ikajdan/PUTM_EV_REARBOX_2023/documentation/rearbox_layout.jpg

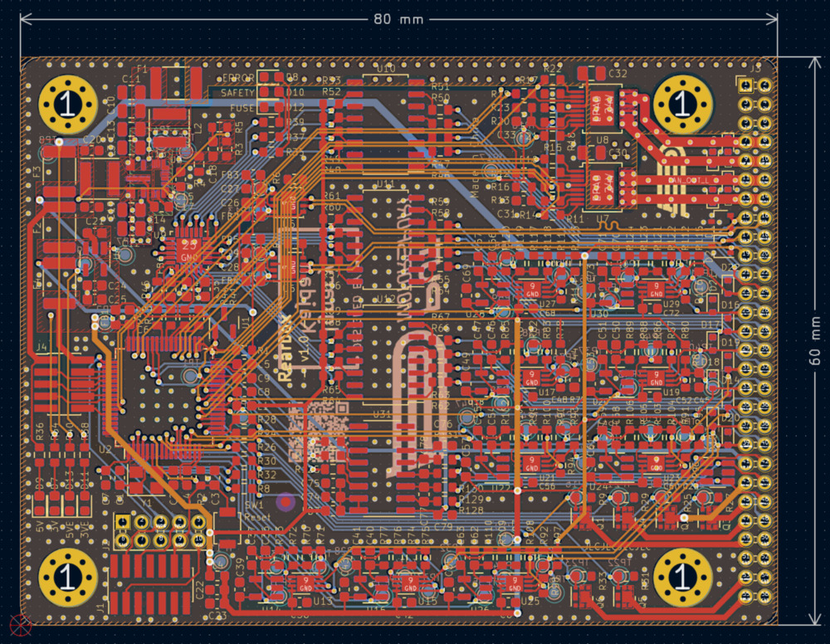
documentation/rearbox_layout.jpg
