ikajdan/PUTM_EV_REARBOX_2023/hardware/connector/models/DTS20W17-35SN.step

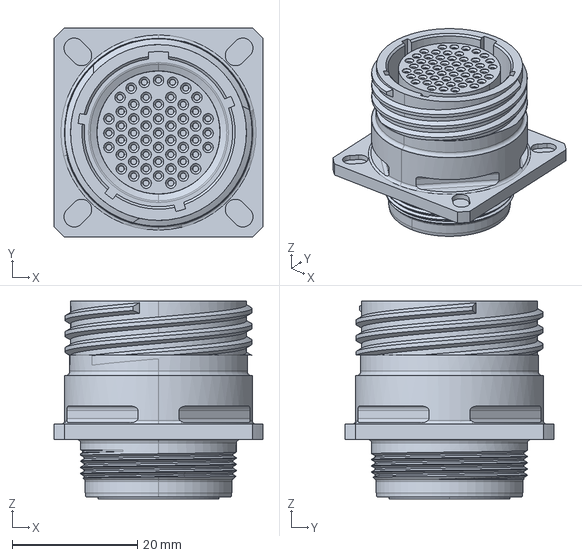
[picture p4: CAD file, 2024-04-28]
hardware/connector/models/DTS20W17-35SN.step
33.4 x 33.4 x 31.6 mm
