ikajdan/PUTM_EV_REARBOX_2023/hardware/rearbox/models/BUK6D210.step

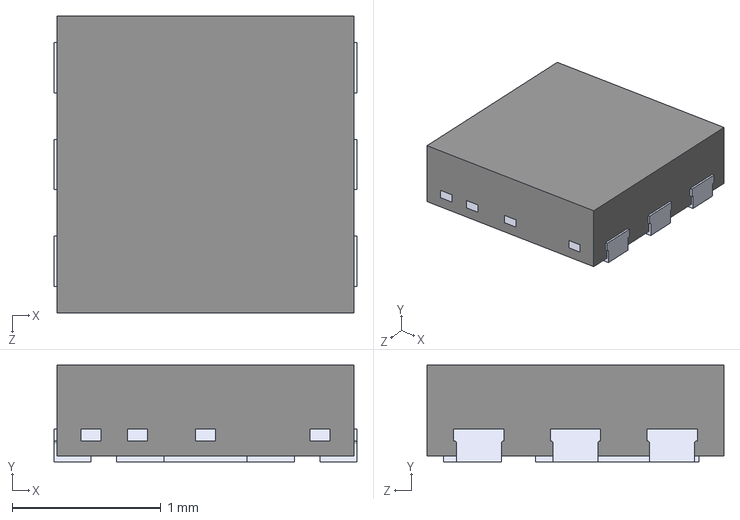
[picture p5: CAD file, 2023-11-16]
hardware/rearbox/models/BUK6D210.step
2.04 x 0.65 x 2.00 mm
