ikajdan/PUTM_EV_REARBOX_2023/hardware/rearbox/models/TCA6416ARTWR.step

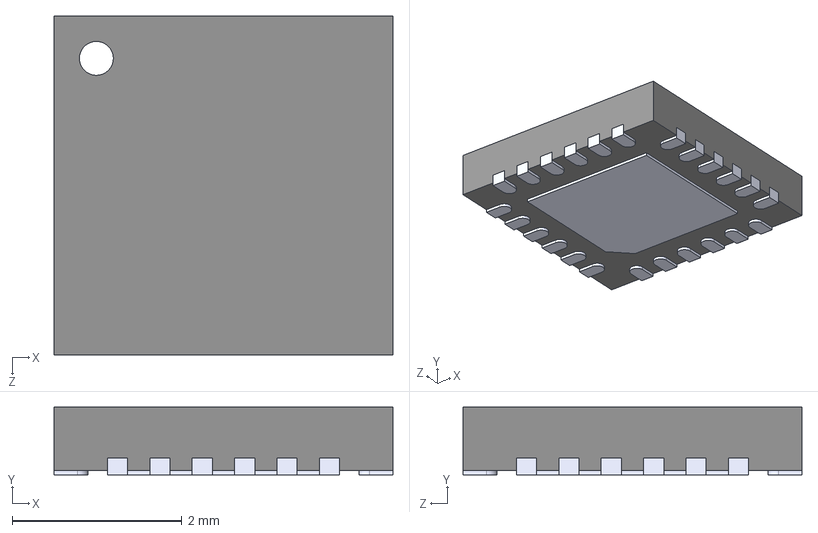
[picture p6: CAD file, 2023-10-03]
hardware/rearbox/models/TCA6416ARTWR.step
4.00 x 0.8 x 4.00 mm
