ikajdan/PUTM_EV_REARBOX_2023/hardware/rearbox/models/LM62440.step

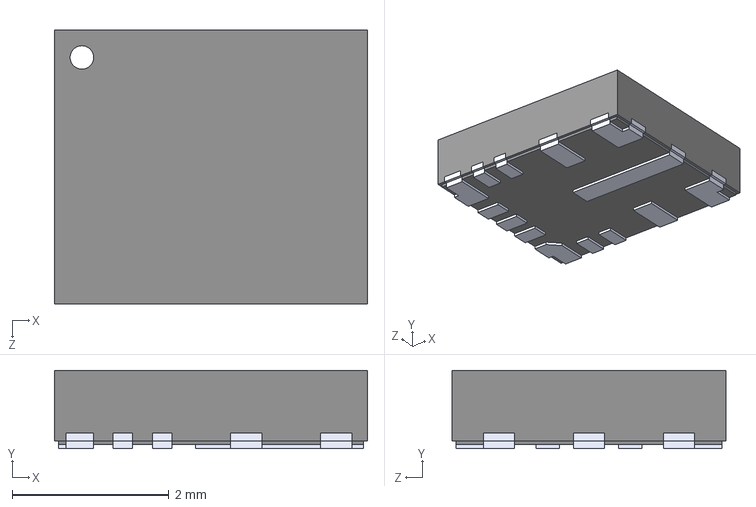
[picture p7: CAD file, 2023-11-16]
hardware/rearbox/models/LM62440.step
4.00 x 1.00 x 3.50 mm
