ikajdan/PUTM_EV_REARBOX_2023/hardware/connector/connector.kicad_pcb

## KiCad design hardware/connector/connector.kicad_pcb (2024-05-31)

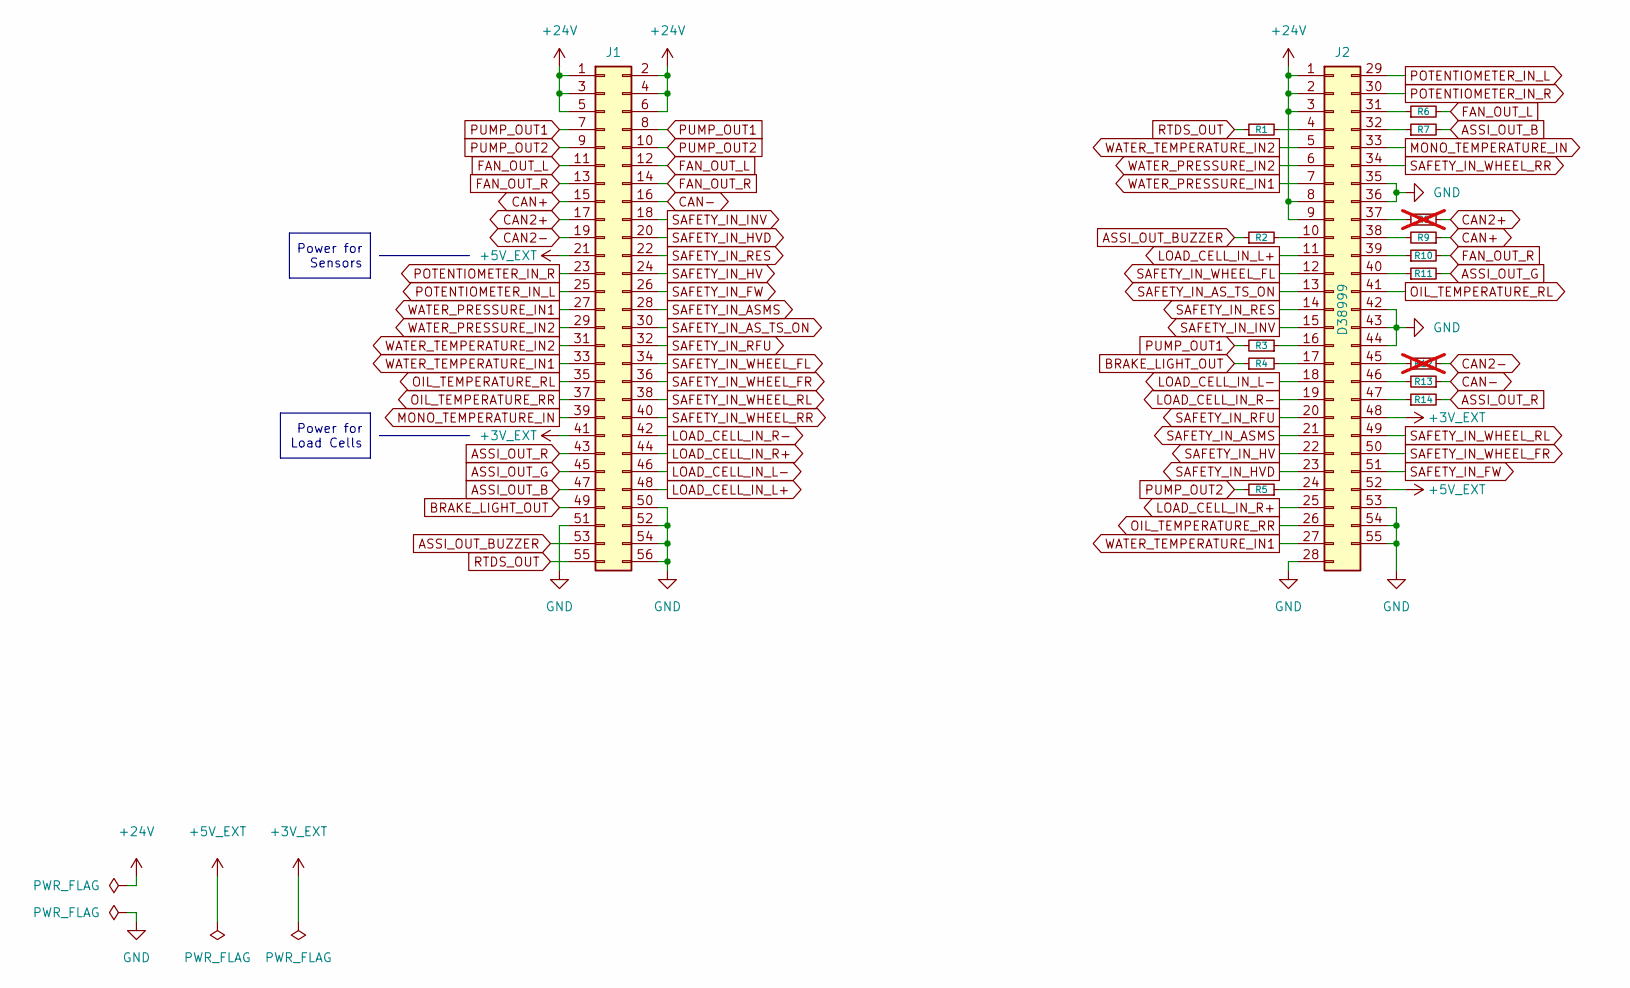
[picture p8: schematic connector.kicad_sch, Connector Board]

Parts:
J1: Conn_02x28_Top_Bottom; PinHeader_2x28_P2.00mm_Horizontal
J2: D38999; DTS20W17-35SN
R1, R2, R3, R4, R5, R6, R7, R9, R10, R11, R13, R14: 0R; R_0603_1608Metric
R8, R12: 0R; R_0603_1608Metric; not fitted

Connections:
+3V_EXT: J1.41, J2.48
+5V_EXT: J1.21, J2.52
+24V: J1.1, J1.2, J1.3, J1.4, J1.5, J1.6, J2.1, J2.2, J2.3, J2.8, J2.9
ASSI_OUT_B: J1.47, R7.2
ASSI_OUT_BUZZER: J1.53, R2.1
ASSI_OUT_G: J1.45, R11.2
ASSI_OUT_R: J1.43, R14.2
BRAKE_LIGHT_OUT: J1.49, R4.1
CAN2+: J1.17, R8.1
CAN2-: J1.19, R12.1
CAN+: J1.15, R9.1
CAN-: J1.16, R13.1
FAN_OUT_L: J1.11, J1.12, R6.2
FAN_OUT_R: J1.13, J1.14, R10.2
GND: J1.50, J1.51, J1.52, J1.54, J1.56, J2.28, J2.35, J2.36, J2.42, J2.43, J2.44, J2.53, J2.54, J2.55
LOAD_CELL_IN_L+: J1.48, J2.11
LOAD_CELL_IN_L-: J1.46, J2.18
LOAD_CELL_IN_R+: J1.44, J2.25
LOAD_CELL_IN_R-: J1.42, J2.19
MONO_TEMPERATURE_IN: J1.39, J2.33
unnamed: J2.4, R1.2
unnamed: J2.10, R2.2
unnamed: J2.16, R3.1
unnamed: J2.17, R4.2
unnamed: J2.24, R5.1
unnamed: J2.31, R6.1
unnamed: J2.32, R7.1
unnamed: J2.37, R8.2
unnamed: J2.38, R9.2
unnamed: J2.39, R10.1
unnamed: J2.40, R11.1
unnamed: J2.45, R12.2
unnamed: J2.46, R13.2
unnamed: J2.47, R14.1
OIL_TEMPERATURE_RL: J1.35, J2.41
OIL_TEMPERATURE_RR: J1.37, J2.26
POTENTIOMETER_IN_L: J1.25, J2.29
POTENTIOMETER_IN_R: J1.23, J2.30
PUMP_OUT1: J1.7, J1.8, R3.2
PUMP_OUT2: J1.9, J1.10, R5.2
RTDS_OUT: J1.55, R1.1
SAFETY_IN_ASMS: J1.28, J2.21
SAFETY_IN_AS_TS_ON: J1.30, J2.13
SAFETY_IN_FW: J1.26, J2.51
SAFETY_IN_HV: J1.24, J2.22
SAFETY_IN_HVD: J1.20, J2.23
SAFETY_IN_INV: J1.18, J2.15
SAFETY_IN_RES: J1.22, J2.14
SAFETY_IN_RFU: J1.32, J2.20
SAFETY_IN_WHEEL_FL: J1.34, J2.12
SAFETY_IN_WHEEL_FR: J1.36, J2.50
SAFETY_IN_WHEEL_RL: J1.38, J2.49
SAFETY_IN_WHEEL_RR: J1.40, J2.34
WATER_PRESSURE_IN1: J1.27, J2.7
WATER_PRESSURE_IN2: J1.29, J2.6
WATER_TEMPERATURE_IN1: J1.33, J2.27
WATER_TEMPERATURE_IN2: J1.31, J2.5

Notes on the sheet:
Power for Sensors
Power for Load Cells

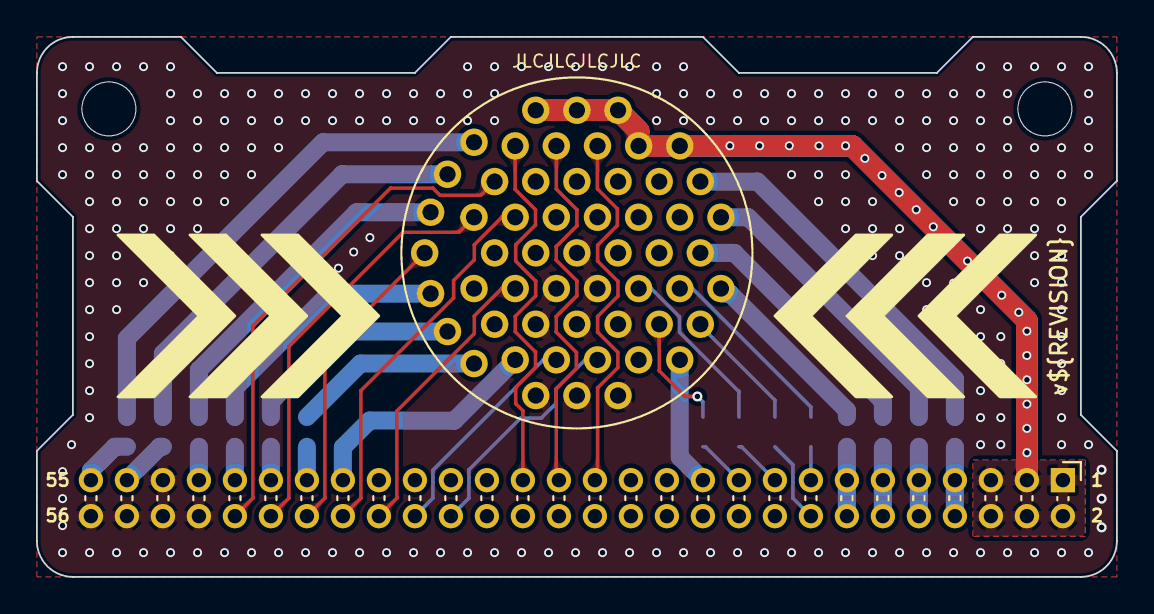
[picture p9: board connector.kicad_pcb from above]

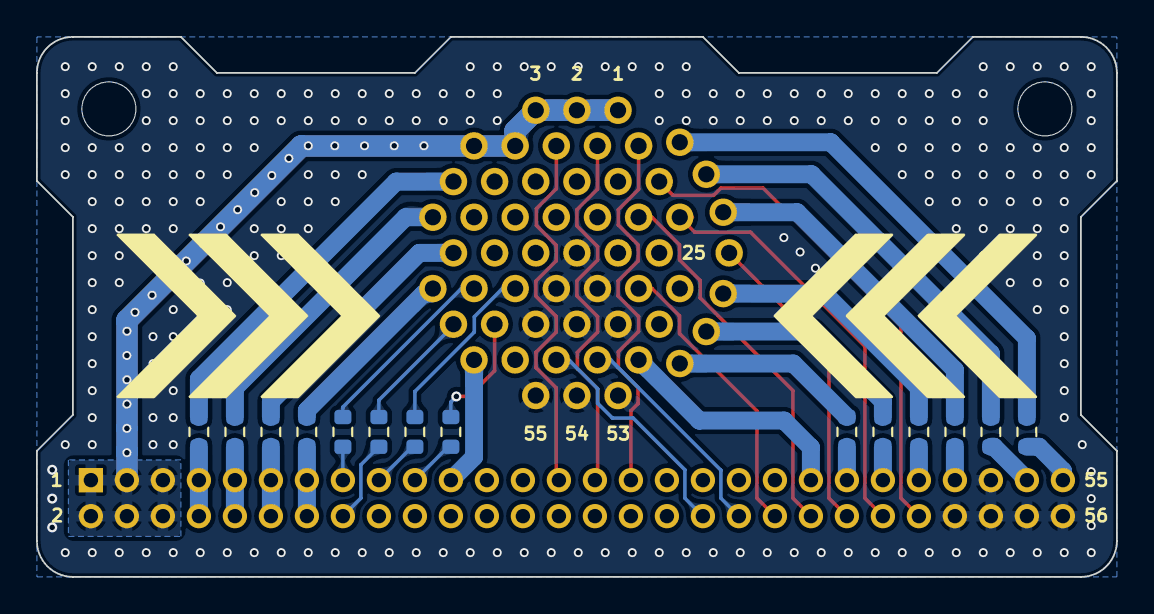
[picture p10: board connector.kicad_pcb from below]

Board: 4 copper layers, 60.0 x 30.0 mm, 16 parts (14 on the bottom side), 57 nets.
