ikajdan/PUTM_EV_REARBOX_2023/hardware/rearbox/rearbox.kicad_pcb

## KiCad design hardware/rearbox/rearbox.kicad_pcb (2023-11-07)

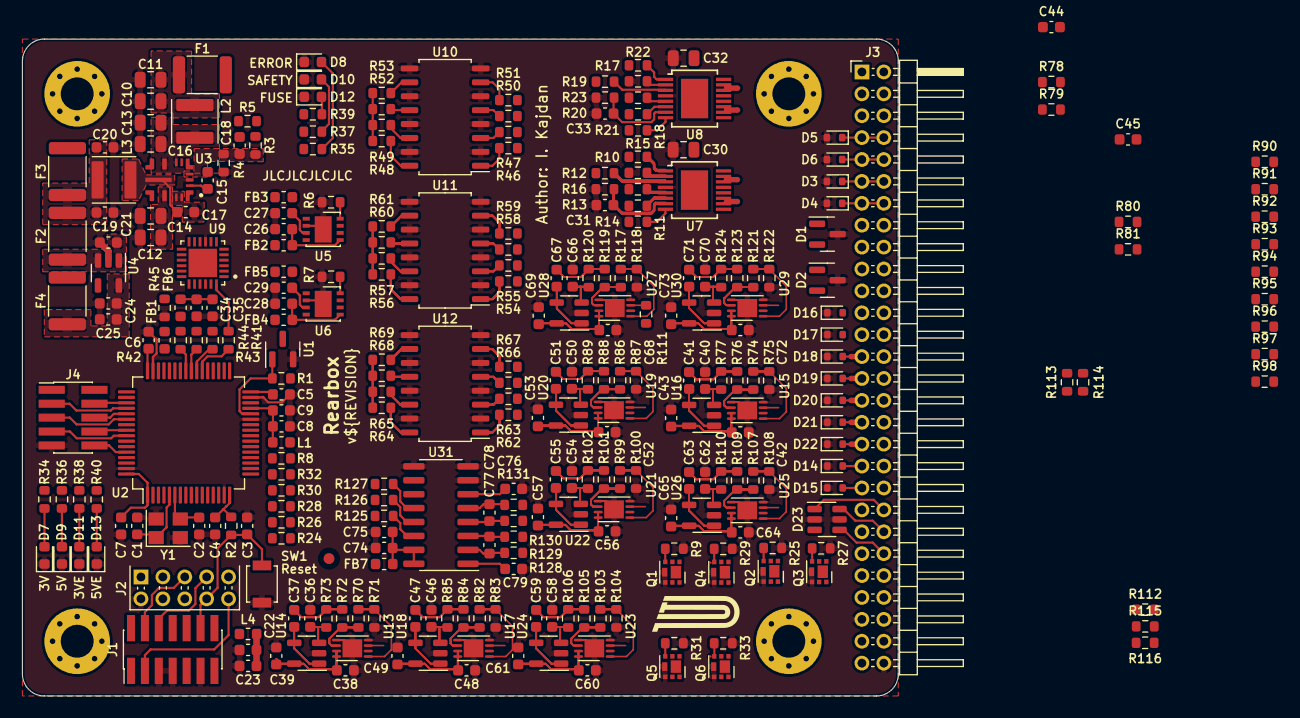
[picture p11: board rearbox.kicad_pcb from above]

Board: 4 copper layers, 80.0 x 60.0 mm, 300 parts (0 on the bottom side), 227 nets.

Parts:
C1, C2: 10p; C_0603_1608Metric
C3, C4, C5, C6, C7, C9, C17, C23, C24, C26, C27, C28, C29, C35, C36, C37, C38, C39, C40, C41, C42, C43, C46, C47, C48, C49, C50, C51, C52, C53, C54, C55, C56, C57, C58, C59, C60, C61, C62, C63, C64, C65, C66, C67, C68, C69, C70, C71, C72, C73, C75, C76, C77, C78: 100n; C_0603_1608Metric
C8, C15, C21, C22, C25, C34, C74, C79: 1u; C_0603_1608Metric
C10, C11: 2u2; C_0805_2012Metric
C12, C13: 4u7; C_0805_2012Metric
C14, C16: 220n; C_0805_2012Metric
C18: 22p; C_0603_1608Metric
C19, C20: 22u; C_0603_1608Metric
C30, C32: 100n; C_0805_2012Metric
C31, C33, C44, C45: 10n; C_0603_1608Metric
D1, D2: PESD2CAN; SOT-23
D3, D4, D5, D6: PMEG3010EB; D_SOD-523
D7, D9, D11, D13: Green; LED_0603_1608Metric
D8, D10, D12: Red; LED_0603_1608Metric
D14, D15, D16, D17, D18, D19, D20, D21, D22: 5V; D_SOD-523
D23: CPDT6-5V4; SOT-23-6
F1: 1.5A; Fuse_1812_4532Metric
F2: 500mA; Fuse_1812_4532Metric
F3: 200mA; Fuse_1812_4532Metric
F4: 100mA; Fuse_1812_4532Metric
FB1, FB2, FB3, FB4, FB5, FB6, FB7: 470R; L_0603_1608Metric
J1: STDC14; PinHeader_2x07_P1.27mm_Vertical_SMD
J2: ST-LINK; STLINK-V3MINIE
J3: Conn_02x28_Top_Bottom; PinHeader_2x28_P2.00mm_Horizontal
J4: Auxiliary; PinHeader_2x05_P1.27mm_Vertical_SMD
L1, L4: 10u; L_0603_1608Metric
L2, L3: 1u5; L_Abracon_ASPI-4030S
NT1, NT2, NT3, NT4, NT5, NT6, NT7, NT8, NT9: NetTie_2; NetTie-2_SMD_Pad0.5mm
Q1, Q2, Q3, Q4, Q5, Q6: BUK6D210; Diodes_UDFN2020-6_Type-F
R1, R5, R90, R91, R92, R93, R95, R97: 1k; R_0603_1608Metric
R2, R9, R25, R27, R29, R31, R33, R48, R49, R52, R53, R56, R57, R60, R61, R64, R65, R68, R69: 10k; R_0603_1608Metric
R3: 100k; R_0603_1608Metric
R4: 24k9; R_0603_1608Metric
R6, R7, R45: 0R; R_0603_1608Metric
R8, R10, R11, R12, R13, R14, R17, R18, R19, R20, R21, R24, R26, R28, R30, R32, R41, R42, R43, R44, R79, R81, R125, R126, R127: 100R; R_0603_1608Metric
R15, R22: 15k; R_0603_1608Metric
R16, R23, R70, R71, R74, R75, R82, R83, R86, R87, R99, R100, R103, R104, R107, R108, R117, R118, R121, R122: TBD; R_0603_1608Metric
R34, R38: 82R; R_0603_1608Metric
R35, R37, R39: 120R; R_0603_1608Metric
R36, R40: 270R; R_0603_1608Metric
R46, R47, R50, R51, R54, R55, R58, R59, R62, R63, R66, R67: 2k; R_0603_1608Metric
R72, R73, R76, R77, R84, R85, R88, R89, R101, R102, R105, R106, R109, R110, R119, R120, R123, R124: 3k3; R_0603_1608Metric
R78, R80: 560R; R_0603_1608Metric
R94, R96, R98: 3k; R_0603_1608Metric
R111, R112, R113, R115: 50k; R_0603_1608Metric
R114, R116: 5k; R_0603_1608Metric
R128, R129, R130, R131: 51R; R_0603_1608Metric
SW1: Reset; SW_SPST_B3U-1000P
U1: LM4040C33FTA; SOT-23
U2: STM32G473RCTx; LQFP-64_10x10mm_P0.5mm
U3: LM62440-Q1; IC_LM61460AANRJRR
U4: TLV743P; SOT-23-5
U5, U6: MCP2542FD; DFN-8-1EP_3x3mm_P0.65mm_EP1.55x2.4mm
U7, U8: VND7020AJTR
U9: TCA6416ARTWR; QFN50P400X400X80-25N
U10, U11, U12: TLP291-4; SOIC-16_4.55x10.3mm_P1.27mm
U13, U15, U17, U19, U21, U23, U25, U27, U29: MCP6N11-005; TDFN-8-1EP_3x2mm_P0.5mm_EP1.80x1.65mm
U14, U16, U18, U20, U22, U24, U26, U28, U30: MCP6001; SOT-23-5
U31: NAU7802SGI; SOIC-16_3.9x9.9mm_P1.27mm
Y1: 48MHz; Crystal_SMD_Abracon_ABM8G-4Pin_3.2x2.5mm

Connections:
+3.3V: C24.1, C25.1, F4.1, FB1.2, FB2.1, FB4.1, FB6.1, FB7.1, J4.1, L1.1, L4.1, R34.1, R48.2, R49.2, R52.2, R53.2, R56.2, R57.2, R60.2, R61.2, R64.2, R65.2, R68.2, R69.2, U4.5 (OUT)
+3.3VA: C22.1, C23.1, C38.1, C39.1, C42.1, C43.1, C48.1, C49.1, C52.1, C53.1, C56.1, C57.1, C60.1, C61.1, C64.1, C65.1, C68.1, C69.1, C72.1, C73.1, L4.2, R78.1, R80.1, U13.7 (V+), U13.8 (EN), U14.5 (V+), U15.7 (V+), U15.8 (EN), U16.5 (V+), U17.7 (V+), U17.8 (EN), U18.5 (V+), U19.7 (V+), U19.8 (EN), U20.5 (V+), U21.7 (V+), U21.8 (EN), U22.5 (V+), U23.7 (V+), U23.8 (EN), U24.5 (V+), U25.7 (V+), U25.8 (EN), U26.5 (V+), U27.7 (V+), U27.8 (EN), U28.5 (V+), U29.7 (V+), U29.8 (EN), U30.5 (V+)
+3V_EXT: C79.1, F4.2, J3.41, R38.1, U31.1 (REFP)
+5V: C19.1, C20.1, F2.1, F3.1, FB3.1, FB5.1, J4.2, L3.2, R1.1, R3.1, R5.1, R36.1, U3.1 (BIAS)
+5V_EXT: F3.2, J3.21, R40.1, R90.1, R91.1, R92.1, R93.1, R95.1, R97.1, R111.1, R112.1, R113.1, R115.1
+24V: C30.1, C32.1, F1.1, J3.1, J3.2, J3.3, J3.4, J3.5, J3.6, U7.EPAD (VCC), U8.EPAD (VCC)
/ANALOG_INPUT1: C37.2, U2.20 (PA6), U14.1, U14.4 (-)
/ANALOG_INPUT2: C41.2, U2.21 (PA7), U16.1, U16.4 (-)
/ANALOG_OFFSET1: U2.18 (PA4), U13.2 (-)
/ANALOG_OFFSET2: U2.19 (PA5), U15.2 (-)
/ASSI_BUZZER: R30.2, U2.4 (PC15)
/ASSI_LED_B: R28.2, U2.17 (PA3)
/ASSI_LED_G: R26.2, U2.9 (PC1)
/ASSI_LED_R: R24.2, U2.8 (PC0)
/BRAKE_LIGHT: R8.2, U2.2 (PC13)
/CAN2_RX: U2.34 (PB12), U6.4 (RXD)
/CAN2_TX: U2.35 (PB13), U6.1 (TXD)
/CAN_RX: U2.45 (PA11), U5.4 (RXD)
/CAN_TX: U2.46 (PA12), U5.1 (TXD)
/FAN_L: R10.1, U2.37 (PB15)
/FAN_R: R11.1, U2.36 (PB14)
/HSE_IN: C1.1, U2.5 (PF0), Y1.1
/HSE_OUT: C2.1, U2.6 (PF1), Y1.3
/LED_ERROR: R35.1, U9.6 (P05)
/LED_FUSE: R39.1, U9.8 (P07)
/LED_SAFETY: R37.1, U9.7 (P06)
/LOAD_CELL_DRDY: R127.1, U2.44 (PA10)
/LOAD_CELL_SCLK: R126.1, U2.43 (PA9)
/LOAD_CELL_SDIO: R125.1, U2.42 (PA8)
/MONO_TEMPERATURE: C63.2, U2.10 (PC2), U26.1, U26.4 (-)
/POTENTIOMETER_L: C67.2, U2.22 (PC4), U28.1, U28.4 (-)
/POTENTIOMETER_R: C71.2, U2.23 (PC5), U30.1, U30.4 (-)
/PUMP1: R17.1, U2.33 (PB11)
/PUMP2: R18.1, U2.30 (PB10)
/Power Supply/+5V_FUSED: C21.1, F2.2, U4.1 (IN), U4.3 (EN)
/Power Supply/+24V_FUSED: C10.1, C11.1, F1.2, L2.1
/Power Supply/FB: C18.2, R3.2, R4.1, U3.4 (FB)
/Power Supply/SW: C17.1, L3.1, U3.10 (SW)
/Power Supply/VIN: C12.1, C13.1, C14.1, C16.1, L2.2, U3.7 (EN), U3.8 (VIN1), U3.12 (VIN2)
/RTDS: R32.2, U2.3 (PC14)
/SAFETY_SCL: R43.1, U2.40 (PC8)
/SAFETY_SDA: R42.1, U2.41 (PC9)
/SAFETY_~INT: R44.1, U2.39 (PC7)
/SAFETY_~RESET: R41.1, U2.38 (PC6)
/SENSE_ADDRESS_IN0: R13.1, R20.1, U2.25 (PB1)
/SENSE_ADDRESS_IN1: R14.1, R21.1, U2.26 (PB2)
/SENSE_ENABLE_FANS: R12.1, U2.59 (PB6)
/SENSE_ENABLE_PUMPS: R19.1, U2.58 (PB5)
/SENSE_OUT: C31.1, C33.1, R16.1, R23.1, U2.24 (PB0), U7.7 (MultiSense), U8.7 (MultiSense)
/Safety Inputs/OUT_ASMS: R65.1, U9.15, U12.14
/Safety Inputs/OUT_FW: R48.1, U9.1 (P00), U10.16
/Safety Inputs/OUT_HV: R49.1, U9.2 (P01), U10.14
/Safety Inputs/OUT_HVD: R53.1, U9.4 (P03), U10.10
/Safety Inputs/OUT_INV: R52.1, U9.3 (P02), U10.12
/Safety Inputs/OUT_RES: R64.1, U9.14, U12.16
/Safety Inputs/OUT_RFU1: R68.1, U9.16, U12.12
/Safety Inputs/OUT_RFU2: R69.1, U9.17, U12.10
/Safety Inputs/OUT_W_FL: R56.1, U9.10, U11.16
/Safety Inputs/OUT_W_FR: R57.1, U9.11, U11.14
/Safety Inputs/OUT_W_RL: R60.1, U9.12, U11.12
/Safety Inputs/OUT_W_RR: R61.1, U9.13, U11.10
/Safety Inputs/TCA_VDD: C34.1, C35.1, FB6.2, U9.21 (VCCP), U9.23 (VCCI)
/Suspension Load Cells/NAU_VDD: C74.1, C75.1, FB7.2, U31.15 (DVDD), U31.16 (AVDD)
/Suspension Potentiometers/N1: R113.2, R114.1, U27.2 (-)
/Suspension Potentiometers/N2: R115.2, R116.1, U29.2 (-)
/Suspension Potentiometers/P1: D21.2 (A2), NT8.2, R111.2, U27.3 (+)
/Suspension Potentiometers/P2: D22.2 (A2), NT9.2, R112.2, U29.3 (+)
/Temperature Sensors/N1: R93.2, R94.1, U21.2 (-)
/Temperature Sensors/N2: R95.2, R96.1, U23.2 (-)
/Temperature Sensors/N3: R97.2, R98.1, U25.2 (-)
/Temperature Sensors/P1: D18.2 (A2), NT5.2, R90.2, U21.3 (+)
/Temperature Sensors/P2: D19.2 (A2), NT6.2, R91.2, U23.3 (+)
/Temperature Sensors/P3: D20.2 (A2), NT7.2, R92.2, U25.3 (+)
/VREF: R1.2, U1.1 (K), U2.28 (VREF+)
/WATER_PRESSURE1: C47.2, U2.13 (PA1), U18.1, U18.4 (-)
/WATER_PRESSURE2: C51.2, U2.14 (PA2), U20.1, U20.4 (-)
/WATER_TEMPERATURE1: C55.2, U2.11 (PC3), U22.1, U22.4 (-)
/WATER_TEMPERATURE2: C59.2, U2.12 (PA0), U24.1, U24.4 (-)
/Water Pressure Sensors/Analog Input 3/-: C44.1, R78.2, R79.1, U17.2 (-)
/Water Pressure Sensors/Analog Input 4/-: C45.1, R80.2, R81.1, U19.2 (-)
ANALOG_IN_RFU1: D14.2 (A2), J3.37, U13.3 (+)
ANALOG_IN_RFU2: D15.2 (A2), J3.39, U15.3 (+)
ASSI_OUT_B: J3.47, Q4.1 (D), Q4.2 (D), Q4.5 (D), Q4.6 (D), Q4.7 (D)
ASSI_OUT_BUZZER: J3.53, Q5.1 (D), Q5.2 (D), Q5.5 (D), Q5.6 (D), Q5.7 (D)
ASSI_OUT_G: J3.45, Q3.1 (D), Q3.2 (D), Q3.5 (D), Q3.6 (D), Q3.7 (D)
ASSI_OUT_R: J3.43, Q2.1 (D), Q2.2 (D), Q2.5 (D), Q2.6 (D), Q2.7 (D)
BRAKE_LIGHT_OUT: J3.49, Q1.1 (D), Q1.2 (D), Q1.5 (D), Q1.6 (D), Q1.7 (D)
CAN2+: D2.1 (A1), J3.17, U6.7 (CANH)
CAN2-: D2.2 (A2), J3.19, U6.6 (CANL)
CAN+: D1.1 (A1), J3.15, U5.7 (CANH)
CAN-: D1.2 (A2), J3.16, U5.6 (CANL)
FAN_OUT_L: D3.1 (K), J3.11, J3.12, NT1.1, NT1.2, U7.13 (OUTPUT0), U7.14 (OUTPUT0), U7.15 (OUTPUT0), U7.16 (OUTPUT0)
FAN_OUT_R: D4.1 (K), J3.13, J3.14, NT2.1, NT2.2, U7.9 (OUTPUT1), U7.10 (OUTPUT1), U7.11 (OUTPUT1), U7.12 (OUTPUT1)
GND: C1.2, C2.2, C3.2, C4.2, C5.2, C6.2, C7.2, C8.2, C9.2, C10.2, C11.2, C12.2, C13.2, C14.2, C15.2, C16.2, C19.2, C20.2, C21.2, C22.2, C23.2, C24.2, C25.2, C26.2, C27.2, C28.2, C29.2, C30.2, C31.2, C32.2, C33.2, C34.2, C35.2, C36.2, C38.2, C39.2, C40.2, C42.2, C43.2, C44.2, C45.2, C46.2, C48.2, C49.2, C50.2, C52.2, C53.2, C54.2, C56.2, C57.2, C58.2, C60.2, C61.2, C62.2, C64.2, C65.2, C66.2, C68.2, C69.2, C70.2, C72.2, C73.2, C74.2, C75.2, C76.2, C79.2, D1.3 (common), D2.3 (common), D3.2 (A), D4.2 (A), D5.2 (A), D6.2 (A), D7.1 (K), D8.1 (K), D9.1 (K), D10.1 (K), D11.1 (K), D12.1 (K), D13.1 (K), D14.1 (A1), D15.1 (A1), D16.1 (A1), D17.1 (A1), D18.1 (A1), D19.1 (A1), D20.1 (A1), D21.1 (A1), D22.1 (A1), D23.2 (D2), D23.5 (A5), J1.5, J1.7, J1.11, J2.6 (GND), J3.50, J3.51, J3.52, J3.54, J3.56, J4.9, Q1.4 (S), Q1.8 (S), Q2.4 (S), Q2.8 (S), Q3.4 (S), Q3.8 (S), Q4.4 (S), Q4.8 (S), Q5.4 (S), Q5.8 (S), Q6.4 (S), Q6.8 (S), R4.2, R6.1, R7.1, R9.1, R15.2, R16.2, R22.2, R23.2, R25.1, R27.1, R29.1, R31.1, R33.1, R45.1, R71.1, R75.1, R79.2, R81.2, R83.1, R87.1, R94.2, R96.2, R98.2, R100.1, R104.1, R108.1, R114.2, R116.2, R118.1, R122.1, SW1.1, U1.2 (A), U2.15 (VSS), U2.27 (VSSA), U2.31 (VSS), U2.47 (VSS), U2.63 (VSS), U3.3 (AGND), U3.6 (MODE/SYNC), U3.9 (PGND1), U3.11 (PGND2), U4.2 (GND), U5.2 (VSS), U5.9 (VSS), U6.2 (VSS), U6.9 (VSS), U7.4 (GND), U8.4 (GND), U9.9 (GND), U9.25 (EP), U10.2, U10.4, U10.6, U10.8, U10.9, U10.11, U10.13, U10.15, U11.2, U11.4, U11.6, U11.8, U11.9, U11.11, U11.13, U11.15, U12.2, U12.4, U12.6, U12.8, U12.9, U12.11, U12.13, U12.15, U13.4 (V-), U13.5 (RF), U13.9 (EP), U14.2 (V-), U15.4 (V-), U15.5 (RF), U15.9 (EP), U16.2 (V-), U17.4 (V-), U17.5 (RF), U17.9 (EP), U18.2 (V-), U19.4 (V-), U19.5 (RF), U19.9 (EP), U20.2 (V-), U21.4 (V-), U21.5 (RF), U21.9 (EP), U22.2 (V-), U23.4 (V-), U23.5 (RF), U23.9 (EP), U24.2 (V-), U25.4 (V-), U25.5 (RF), U25.9 (EP), U26.2 (V-), U27.4 (V-), U27.5 (RF), U27.9 (EP), U28.2 (V-), U29.4 (V-), U29.5 (RF), U29.9 (EP), U30.2 (V-), U31.7 (REFN), U31.8 (AVSS), U31.9 (DVSS), Y1.2, Y1.4
I^{2}C_SCL: J4.4, U2.51 (PA15)
I^{2}C_SDA: J4.10, U2.60 (PB7)
LOAD_CELL_IN_L+: D23.1 (A1), J3.42, R128.2
LOAD_CELL_IN_L-: D23.6 (D6), J3.44, R129.2
LOAD_CELL_IN_R+: D23.4 (C4), J3.46, R130.2
LOAD_CELL_IN_R-: D23.3 (B3), J3.48, R131.2
MONO_TEMPERATURE_IN: J3.31, NT7.1
NRST: C3.1, J1.12, J2.9 (T_NRST), R2.2, SW1.2, U2.7 (PG10)
unnamed: C18.1, R5.2
unnamed: C37.1, R72.2, R73.1
unnamed: C41.1, R76.2, R77.1
unnamed: C47.1, R84.2, R85.1
unnamed: C51.1, R88.2, R89.1
unnamed: C55.1, R101.2, R102.1
unnamed: C59.1, R105.2, R106.1
unnamed: C63.1, R109.2, R110.1
unnamed: C67.1, R119.2, R120.1
unnamed: C71.1, R123.2, R124.1
unnamed: D7.2 (A), R34.2
unnamed: D8.2 (A), R35.2
unnamed: D9.2 (A), R36.2
unnamed: D10.2 (A), R37.2
unnamed: D11.2 (A), R38.2
unnamed: D12.2 (A), R39.2
unnamed: D13.2 (A), R40.2
unnamed: Q1.3 (G), R8.1, R9.2
unnamed: Q2.3 (G), R24.1, R25.2
unnamed: Q3.3 (G), R26.1, R27.2
unnamed: Q4.3 (G), R28.1, R29.2
unnamed: Q5.3 (G), R30.1, R31.2
unnamed: Q6.3 (G), R32.1, R33.2
unnamed: R46.2, U10.1
unnamed: R47.2, U10.3
unnamed: R50.2, U10.5
unnamed: R51.2, U10.7
unnamed: R54.2, U11.1
unnamed: R55.2, U11.3
unnamed: R58.2, U11.5
unnamed: R59.2, U11.7
unnamed: R62.2, U12.1
unnamed: R63.2, U12.3
unnamed: R66.2, U12.5
unnamed: R67.2, U12.7
unnamed: R70.2, R72.1, U13.6
unnamed: R74.2, R76.1, U15.6
unnamed: R82.2, R84.1, U17.6
unnamed: R86.2, R88.1, U19.6
unnamed: R99.2, R101.1, U21.6
unnamed: R103.2, R105.1, U23.6
unnamed: R107.2, R109.1, U25.6
unnamed: R117.2, R119.1, U27.6
unnamed: R121.2, R123.1, U29.6
unnamed: C17.2, U3.13 (RBOOT), U3.14 (CBOOT)
unnamed: C15.1, U3.2 (VCC)
unnamed: R6.2, U5.8 (STBY)
unnamed: C27.1, FB3.2, U5.3 (VDD)
unnamed: C26.1, FB2.2, U5.5 (VIO)
unnamed: R7.2, U6.8 (STBY)
unnamed: C29.1, FB5.2, U6.3 (VDD)
unnamed: C28.1, FB4.2, U6.5 (VIO)
unnamed: R10.2, U7.1 (INPUT0)
unnamed: R11.2, U7.8 (INPUT1)
unnamed: R13.2, U7.5 (SEL0)
unnamed: R14.2, U7.6 (SEL1)
unnamed: R12.2, U7.3 (SEn)
unnamed: R15.1, U7.2 (~FaultRST)
unnamed: R17.2, U8.1 (INPUT0)
unnamed: R18.2, U8.8 (INPUT1)
unnamed: R20.2, U8.5 (SEL0)
unnamed: R21.2, U8.6 (SEL1)
unnamed: R19.2, U8.3 (SEn)
unnamed: R22.1, U8.2 (~FaultRST)
unnamed: R45.2, U9.18 (ADDR)
unnamed: R43.2, U9.19 (SCL)
unnamed: R42.2, U9.20 (SDA)
unnamed: R44.2, U9.22 (~INT)
unnamed: R41.2, U9.24 (~RESET)
unnamed: R70.1, R71.2, U13.1 (FG)
unnamed: C36.1, R73.2, U14.3 (+)
unnamed: R74.1, R75.2, U15.1 (FG)
unnamed: C40.1, R77.2, U16.3 (+)
unnamed: R82.1, R83.2, U17.1 (FG)
unnamed: C46.1, R85.2, U18.3 (+)
unnamed: R86.1, R87.2, U19.1 (FG)
unnamed: C50.1, R89.2, U20.3 (+)
unnamed: R99.1, R100.2, U21.1 (FG)
unnamed: C54.1, R102.2, U22.3 (+)
unnamed: R103.1, R104.2, U23.1 (FG)
unnamed: C58.1, R106.2, U24.3 (+)
unnamed: R107.1, R108.2, U25.1 (FG)
unnamed: C62.1, R110.2, U26.3 (+)
unnamed: R117.1, R118.2, U27.1 (FG)
unnamed: C66.1, R120.2, U28.3 (+)
unnamed: R121.1, R122.2, U29.1 (FG)
unnamed: C70.1, R124.2, U30.3 (+)
unnamed: R127.2, U31.12 (DRDY)
unnamed: R126.2, U31.13 (SCLK)
unnamed: R125.2, U31.14 (SDIO)
unnamed: C76.1, U31.6 (VBG)
unnamed: C77.1, R128.1, U31.2 (VIN1N)
unnamed: C77.2, R129.1, U31.3 (VIN1P)
unnamed: C78.1, R130.1, U31.4 (VIN2N)
unnamed: C78.2, R131.1, U31.5 (VIN2P)
POTENTIOMETER_IN_L: J3.33, NT8.1
POTENTIOMETER_IN_R: J3.35, NT9.1
PUMP_OUT1: D5.1 (K), J3.7, J3.8, NT3.1, NT3.2, U8.13 (OUTPUT0), U8.14 (OUTPUT0), U8.15 (OUTPUT0), U8.16 (OUTPUT0)
PUMP_OUT2: D6.1 (K), J3.9, J3.10, NT4.1, NT4.2, U8.9 (OUTPUT1), U8.10 (OUTPUT1), U8.11 (OUTPUT1), U8.12 (OUTPUT1)
RTDS_OUT: J3.55, Q6.1 (D), Q6.2 (D), Q6.5 (D), Q6.6 (D), Q6.7 (D)
SAFETY_IN_ASMS: J3.28, R63.1
SAFETY_IN_FW: J3.26, R46.1
SAFETY_IN_HV: J3.24, R47.1
SAFETY_IN_HVD: J3.20, R51.1
SAFETY_IN_INV: J3.18, R50.1
SAFETY_IN_RES: J3.22, R62.1
SAFETY_IN_RFU1: J3.30, R66.1
SAFETY_IN_RFU2: J3.32, R67.1
SAFETY_IN_WHEEL_FL: J3.34, R54.1
SAFETY_IN_WHEEL_FR: J3.36, R55.1
SAFETY_IN_WHEEL_RL: J3.38, R58.1
SAFETY_IN_WHEEL_RR: J3.40, R59.1
SPI_MISO: J4.7, U2.57 (PB4)
SPI_MOSI: J4.5, U2.54 (PC12)
SPI_SCLK: J4.8, U2.56 (PB3)
SWCLK: J1.6, J2.4 (T_JCLK/T_SWCLK), U2.50 (PA14)
SWDIO: J1.4, J2.3 (T_JTMS/T_SWDIO), U2.49 (PA13)
UART_RX: J4.6, U2.53 (PC11)
UART_TX: J4.3, U2.52 (PC10)
VDD: C4.1, C5.1, C6.1, C7.1, FB1.1, J1.3, J2.10 (T_VCC), R2.1, U2.1 (VBAT), U2.16 (VDD), U2.32 (VDD), U2.48 (VDD), U2.64 (VDD)
VDDA: C8.1, C9.1, L1.2, U2.29 (VDDA)
WATER_PRESSURE_IN1: D16.2 (A2), J3.23, U17.3 (+)
WATER_PRESSURE_IN2: D17.2 (A2), J3.25, U19.3 (+)
WATER_TEMPERATURE_IN1: J3.27, NT5.1
WATER_TEMPERATURE_IN2: J3.29, NT6.1
