ikajdan/PUTM_EV_REARBOX_2023/firmware/Components/PWM/Src/pwm.c

/**
 ******************************************************************************
 * @file           : pwm.c
 * @brief          : PWM library
 *
 ******************************************************************************
 */

/* Includes ------------------------------------------------------------------*/
#include "pwm.h"
#include "stm32g4xx_hal.h"

/* Typedefs ------------------------------------------------------------------*/

/* Defines -------------------------------------------------------------------*/

/* Macros --------------------------------------------------------------------*/

/* Private variables ---------------------------------------------------------*/

/* Public variables ----------------------------------------------------------*/

/* Private function prototypes -----------------------------------------------*/

/* Public function prototypes ------------------------------------------------*/

/* Private functions ---------------------------------------------------------*/
static float clamp(float value, float min, float max) {
    if(value < min) {
        return min;
    } else if(value > max) {
        return max;
    } else {
        return value;
    }
}

/* Public functions ----------------------------------------------------------*/
void PWM_SetDutyCycle(TIM_HandleTypeDef *const htim, const uint32_t channel, float duty_cycle) {
    duty_cycle = clamp(duty_cycle, 0.0f, 100.0f);
    uint32_t compare = (duty_cycle * (__HAL_TIM_GET_AUTORELOAD(htim) + 1)) / 100;
    __HAL_TIM_SET_COMPARE(htim, channel, compare);
}
