ikajdan/PUTM_EV_REARBOX_2023/firmware/Core/Src/app_freertos.c

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

/* Includes ------------------------------------------------------------------*/
#include "FreeRTOS.h"
#include "cmsis_os.h"
#include "main.h"
#include "task.h"

/* USER CODE BEGIN Includes */
#include "communication_task.h"
#include "interface_task.h"
#include "led_test_task.h"
#include "safety_task.h"
/* USER CODE END Includes */

/* Definitions for defaultTask */
osThreadId_t defaultTaskHandle;
const osThreadAttr_t defaultTask_attributes = {.name = "defaultTask", .priority = (osPriority_t)osPriorityNormal, .stack_size = 128 * 4};
/* Definitions for interfaceTask */
osThreadId_t interfaceTaskHandle;
const osThreadAttr_t interfaceTask_attributes = {.name = "interfaceTask", .priority = (osPriority_t)osPriorityNormal, .stack_size = 256 * 4};
/* Definitions for communicationTask */
osThreadId_t communicationTaskHandle;
const osThreadAttr_t communicationTask_attributes = {.name = "communicationTask", .priority = (osPriority_t)osPriorityNormal, .stack_size = 256 * 4};
/* Definitions for safetyTask */
osThreadId_t safetyTaskHandle;
const osThreadAttr_t safetyTask_attributes = {.name = "safetyTask", .priority = (osPriority_t)osPriorityAboveNormal, .stack_size = 256 * 4};
/* Definitions for ledTestTask */
osThreadId_t ledTestTaskHandle;
const osThreadAttr_t ledTestTask_attributes = {.name = "ledTestTask", .priority = (osPriority_t)osPriorityLow, .stack_size = 128 * 4};
/* Definitions for dataMutex */
osMutexId_t dataMutexHandle;
const osMutexAttr_t dataMutex_attributes = {.name = "dataMutex"};
/* Definitions for safetyMutex */
osMutexId_t safetyMutexHandle;
const osMutexAttr_t safetyMutex_attributes = {.name = "safetyMutex"};

void Default_Task(void* argument);
extern void Interface_Task(void* argument);
extern void Communication_Task(void* argument);
extern void Safety_Task(void* argument);
extern void Led_Test_Task(void* argument);

void MX_FREERTOS_Init(void); /* (MISRA C 2004 rule 8.1) */

/**
 * @brief  FreeRTOS initialization
 * @param  None
 * @retval None
 */
void MX_FREERTOS_Init(void) {
    /* Create the mutex(es) */
    /* creation of dataMutex */
    dataMutexHandle = osMutexNew(&dataMutex_attributes);

    /* creation of safetyMutex */
    safetyMutexHandle = osMutexNew(&safetyMutex_attributes);

    /* USER CODE BEGIN RTOS_MUTEX */
    /* add mutexes, ... */
    /* USER CODE END RTOS_MUTEX */

    /* USER CODE BEGIN RTOS_SEMAPHORES */
    /* add semaphores, ... */
    /* USER CODE END RTOS_SEMAPHORES */

    /* USER CODE BEGIN RTOS_TIMERS */
    /* start timers, add new ones, ... */
    /* USER CODE END RTOS_TIMERS */

    /* USER CODE BEGIN RTOS_QUEUES */
    /* add queues, ... */
    /* USER CODE END RTOS_QUEUES */

    /* Create the thread(s) */
    /* creation of defaultTask */
    defaultTaskHandle = osThreadNew(Default_Task, NULL, &defaultTask_attributes);

    /* creation of interfaceTask */
    interfaceTaskHandle = osThreadNew(Interface_Task, NULL, &interfaceTask_attributes);

    /* creation of communicationTask */
    communicationTaskHandle = osThreadNew(Communication_Task, NULL, &communicationTask_attributes);

    /* creation of safetyTask */
    safetyTaskHandle = osThreadNew(Safety_Task, NULL, &safetyTask_attributes);

    /* creation of ledTestTask */
    ledTestTaskHandle = osThreadNew(Led_Test_Task, NULL, &ledTestTask_attributes);

    /* USER CODE BEGIN RTOS_THREADS */
    /* add threads, ... */
    /* USER CODE END RTOS_THREADS */

    /* USER CODE BEGIN RTOS_EVENTS */
    /* add events, ... */
    /* USER CODE END RTOS_EVENTS */
}

/* USER CODE BEGIN Header_Default_Task */
/**
 * @brief  Function implementing the defaultTask thread.
 * @param  argument: Not used
 * @retval None
 */
/* USER CODE END Header_Default_Task */
void Default_Task(void* argument) {
    /* USER CODE BEGIN Default_Task */
    /* Infinite loop */
    for(;;) {
        osDelay(1);
    }
    /* USER CODE END Default_Task */
}
