ikajdan/PUTM_EV_REARBOX_2023/firmware/Core/Inc/interface_task.h

/**
 ******************************************************************************
 * @file           : interface_task.h
 * @brief          : Input/output interfacing task
 *
 ******************************************************************************
 */

#ifndef __INTERFACE_TASK_H__
#define __INTERFACE_TASK_H__

/* Public includes -----------------------------------------------------------*/
#ifdef __cplusplus
extern "C" {
#endif

void Interface_Task(void* argument);

#ifdef __cplusplus
}
#endif

/* Public typedefs -----------------------------------------------------------*/

/* Public defines ------------------------------------------------------------*/

/* Public macros -------------------------------------------------------------*/

/* Public variables ----------------------------------------------------------*/

/* Public function prototypes ------------------------------------------------*/

#endif /* __INTERFACE_TASK_H__ */
