ikajdan/PUTM_EV_REARBOX_2023/firmware/Components/AIN/Inc/ain_conf.h

/**
 ******************************************************************************
 * @file           : ain_conf.h
 * @brief          : AIN library configuration
 *
 ******************************************************************************
 */

#ifndef __AIN_CONFIG_H__
#define __AIN_CONFIG_H__

/* Public includes -----------------------------------------------------------*/

/* Public typedefs -----------------------------------------------------------*/

/* Public defines ------------------------------------------------------------*/
/**
 * @brief Number of ADC1 channels
 */
#define AIN_ADC1_CHANNELS 6

/**
 * @brief Number of ADC2 channels
 */
#define AIN_ADC2_CHANNELS 4

/* Public macros -------------------------------------------------------------*/

/* Public variables ----------------------------------------------------------*/

/* Public function prototypes ------------------------------------------------*/

#endif /* __AIN_CONFIG_H__ */
