ikajdan/PUTM_EV_REARBOX_2023/(commit log)

2023-04-24 Generate KiCad project from the template
    [rearbox.kicad_pcb, rearbox.kicad_sch]
2023-06-08 Add components
    [analog_input.kicad_sch, analog_inputs.kicad_sch, assi.kicad_sch, autosport.kicad_sch, brake_light.kicad_sch, can_transceiver.kicad_sch, can_transceivers.kicad_sch, connectors.kicad_sch]
2023-07-01 Add the Cube project
    [TCA6416ARTWR.step, analog_input.kicad_sch, analog_inputs.kicad_sch, assi.kicad_sch, autosport.kicad_sch, brake_light.kicad_sch, can_transceiver.kicad_sch, can_transceivers.kicad_sch]
2023-07-07 Improve the schematic
    - add anti-aliasing filters
    - rearrange the main connector signals
    - improve the power filtering
    [analog_input.kicad_sch, analog_inputs.kicad_sch, assi.kicad_sch, autosport.kicad_sch, brake_light.kicad_sch, can_transceiver.kicad_sch, can_transceivers.kicad_sch, fans.kicad_sch]
2023-07-28 Set component values
    [analog_input.kicad_sch, analog_inputs.kicad_sch, assi.kicad_sch, autosport.kicad_sch, brake_light.kicad_sch, can_transceiver.kicad_sch, fans.kicad_sch, leds.kicad_sch]
2023-07-28 Number subsheets in order
    [analog_inputs.kicad_sch, can_transceivers.kicad_sch, rearbox.kicad_sch, suspension_potentiometers.kicad_sch, temperature_sensors.kicad_sch, water_pressure_sensors.kicad_sch]
2023-09-19 Improve the schematic according to the feedback
    [analog_input.kicad_sch, analog_inputs.kicad_sch, assi.kicad_sch, autosport.kicad_sch, brake_light.kicad_sch, can_transceiver.kicad_sch, fans.kicad_sch, leds.kicad_sch]
2023-09-23 Add high-side drivers to the fans and pumps
    [analog_input.kicad_sch, analog_inputs.kicad_sch, assi.kicad_sch, autosport.kicad_sch, brake_light.kicad_sch, can_transceiver.kicad_sch, can_transceivers.kicad_sch, fans.kicad_sch]
2023-09-23 Use in-amps
    [autosport.kicad_sch, power_supply.kicad_sch, suspension_potentiometer.kicad_sch, temperature_sensor.kicad_sch, water_pressure_sensor.kicad_sch]
2023-10-03 Improve the diagram based on the feedback
    - add an input LC filter
    - remove the USB connector
    - add a programmer connector
    - move optocouplers into a subsheet
    - add a suspension tension meter IC
    [analog_input.kicad_sch, analog_inputs.kicad_sch, assi.kicad_sch, autosport.kicad_sch, brake_light.kicad_sch, can_transceiver.kicad_sch, can_transceivers.kicad_sch, fans.kicad_sch]
2023-10-03 Add the connector board
    [TCA6416ARTWR.step, analog_input.kicad_sch, analog_inputs.kicad_sch, assi.kicad_sch, brake_light.kicad_sch, can_transceiver.kicad_sch, can_transceivers.kicad_sch, connector.kicad_pcb]
2023-11-02 Place components on the PCB
    [analog_input.kicad_sch, analog_input_dnp.kicad_sch, analog_inputs.kicad_sch, assi.kicad_sch, brake_light.kicad_sch, can_transceiver.kicad_sch, can_transceivers.kicad_sch, connector.kicad_sch]
2023-11-07 Align footprint references
    [analog_input.kicad_sch, assi.kicad_sch, brake_light.kicad_sch, can_transceiver.kicad_sch, connectors.kicad_sch, fused_output.kicad_sch, leds.kicad_sch, power_supply.kicad_sch]
2023-11-16 Route PCB tracks
    [BUK6D210.step, LM62440.step, assi.kicad_sch, brake_light.kicad_sch, can_transceiver.kicad_sch, connector.kicad_pcb, connector.kicad_sch, connectors.kicad_sch]
2023-11-17 Fix DRCs
    [analog_input.kicad_sch, analog_inputs.kicad_sch, assi.kicad_sch, brake_light.kicad_sch, can_transceiver.kicad_sch, can_transceivers.kicad_sch, connectors.kicad_sch, fused_output.kicad_sch]
2023-11-17 Improve the routing of pump drivers and CAN buses
2024-02-13 Add pwm, adc and VND7020AJ components
2024-02-13 Route the tracks on the connector PCB
    [DTS20W17-35SN.step, analog_input.kicad_sch, assi.kicad_sch, brake_light.kicad_sch, can_transceiver.kicad_sch, connector.kicad_pcb, connector.kicad_sch, connectors.kicad_sch]
2024-02-20 Add the connector model
2024-03-04 Add TCA driver
2024-04-28 Fix measurement bridges polarity
    [analog_input.kicad_sch, analog_inputs.kicad_sch, assi.kicad_sch, brake_light.kicad_sch, can_transceiver.kicad_sch, can_transceivers.kicad_sch, connector.kicad_sch, connectors.kicad_sch]
2024-05-31 Fix connector wiring
    [connector.kicad_pcb, connector.kicad_sch]
2024-06-24 Control brake light and RTDS
2024-07-02 Handle LEDs
2024-07-06 Add enclosure CAD files
2024-07-07 Add spacers
2024-07-18 Update schematic to reflect hardware changes
    [analog_input.kicad_sch, analog_inputs.kicad_sch, assi.kicad_sch, brake_light.kicad_sch, can_transceiver.kicad_sch, can_transceivers.kicad_sch, connectors.kicad_sch, fused_output.kicad_sch]
2024-08-07 Publish temperature data
